BurntPineapples/kaboombox/hardware/enclosure/controller_full.step

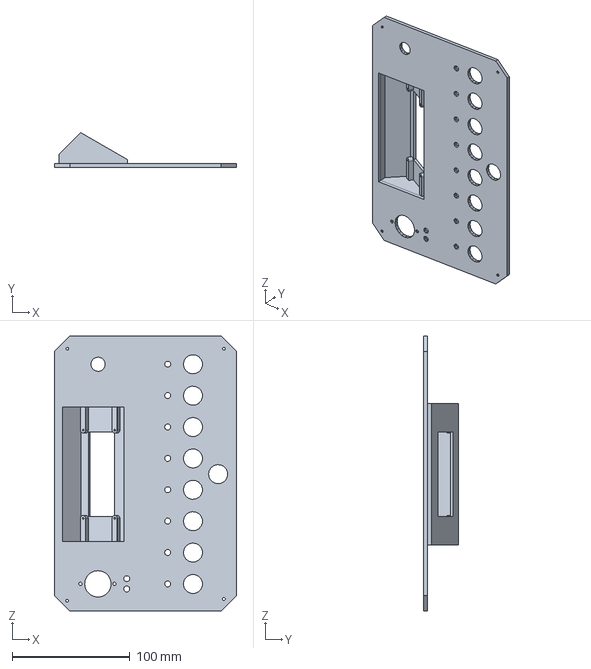
[picture p12: CAD file, 2026-11-06]
hardware/enclosure/controller_full.step
154.9 x 29.7 x 233.7 mm
