BurntPineapples/kaboombox/hardware/enclosure/field_floor_test.stl

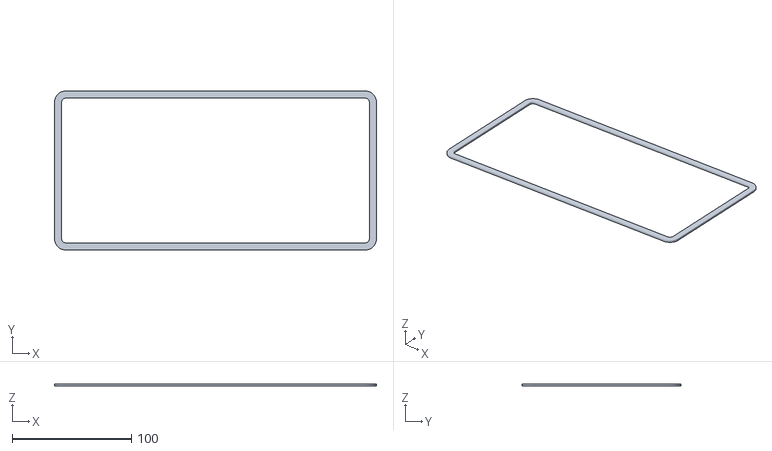
[picture p13: CAD file, 2026-11-06]
hardware/enclosure/field_floor_test.stl
269.9 x 133.4 x 2.00
