BurntPineapples/kaboombox/hardware/enclosure/plate-source/Controller_9.200x6.100.stl

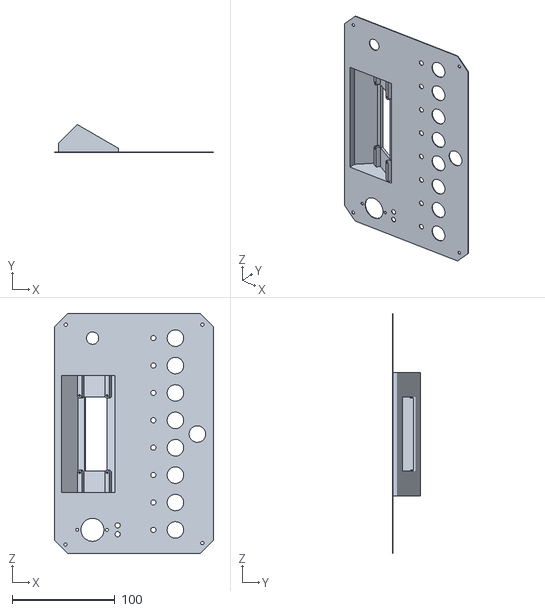
[picture p14: CAD file, 2026-11-06]
hardware/enclosure/plate-source/Controller_9.200x6.100.stl
154.9 x 27.1 x 233.7
