BurntPineapples/kaboombox/hardware/enclosure/field_prop.step

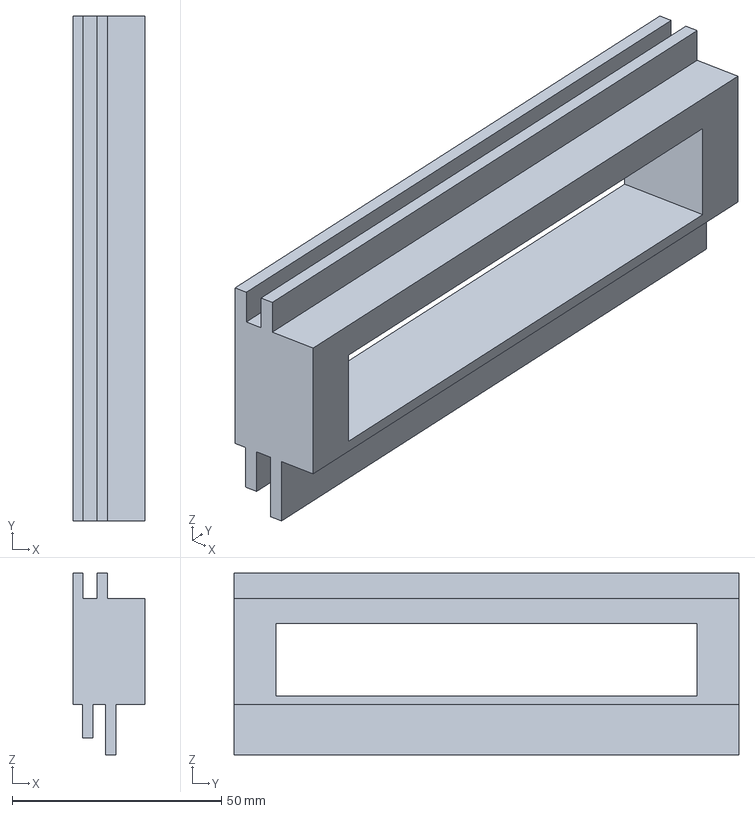
[picture p15: CAD file, 2026-11-06]
hardware/enclosure/field_prop.step
17.3 x 120.7 x 43.4 mm
