BurntPineapples/kaboombox/hardware/enclosure/plate-source/Controller.stl

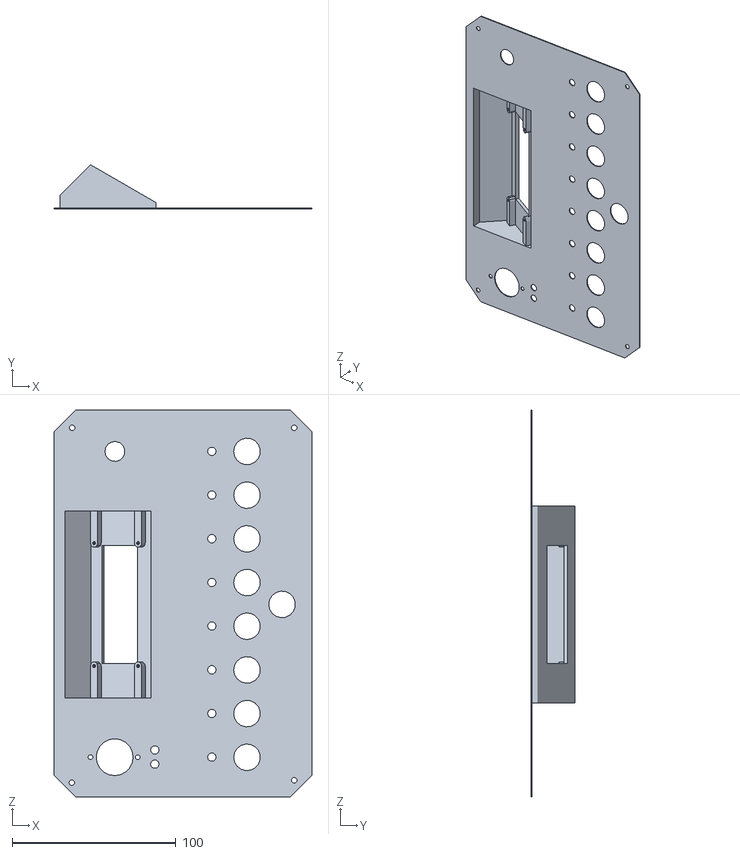
[picture p16: CAD file, 2026-11-06]
hardware/enclosure/plate-source/Controller.stl
157.5 x 27.1 x 236.2
