BurntPineapples/kaboombox/hardware/enclosure/controller_plate_test.stl

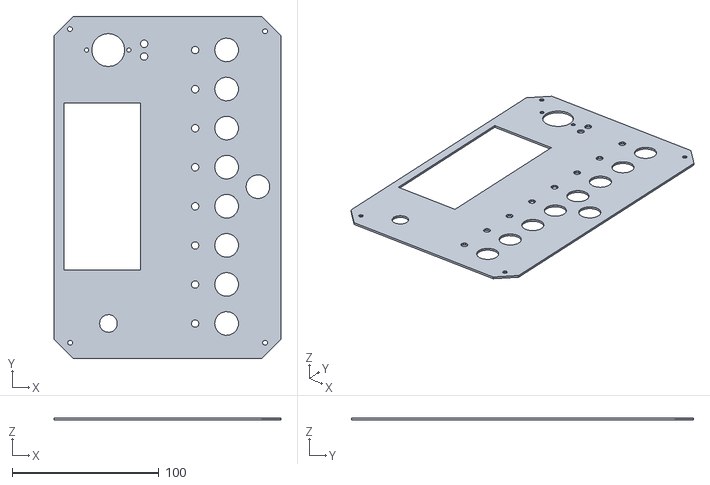
[picture p17: CAD file, 2026-11-06]
hardware/enclosure/controller_plate_test.stl
154.9 x 233.7 x 1.50
