BurntPineapples/kaboombox/hardware/enclosure/legs_placed.step

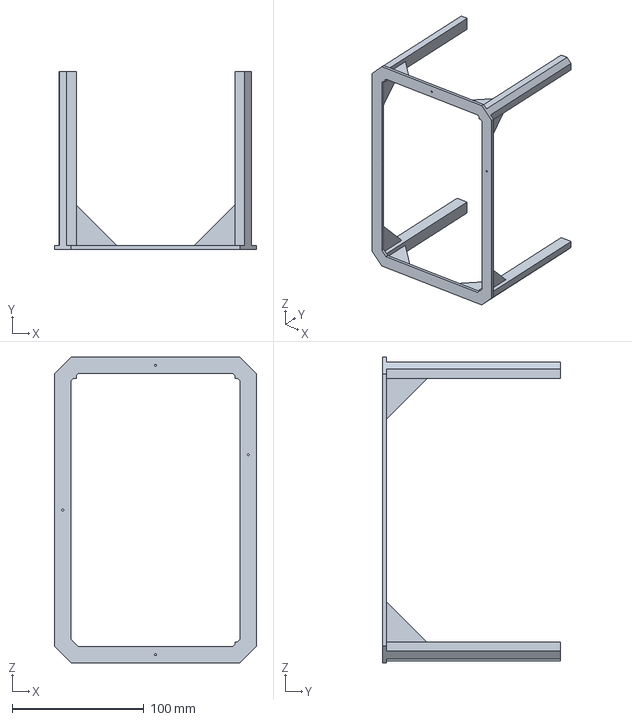
[picture p18: CAD file, 2026-11-06]
hardware/enclosure/legs_placed.step
153.4 x 134.9 x 232.2 mm
