BurntPineapples/kaboombox/hardware/enclosure/field_floor.step

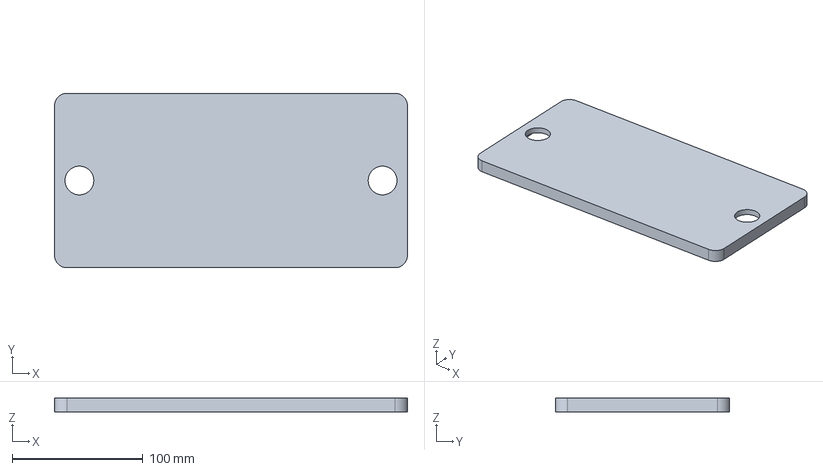
[picture p19: CAD file, 2026-11-06]
hardware/enclosure/field_floor.step
269.9 x 133.3 x 11.0 mm
