BurntPineapples/kaboombox/hardware/enclosure/legs_test.stl

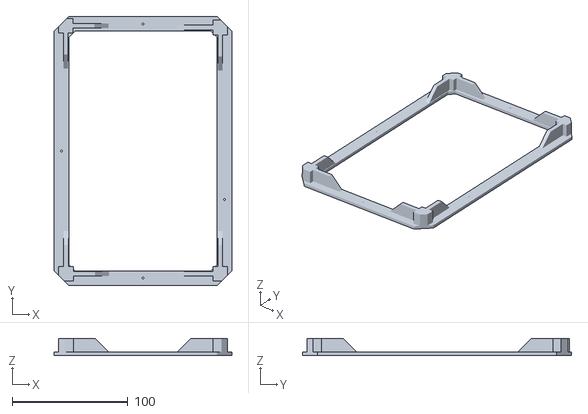
[picture p20: CAD file, 2026-11-06]
hardware/enclosure/legs_test.stl
153.4 x 232.2 x 15.0
