BurntPineapples/kaboombox/hardware/enclosure/tray_print.stl

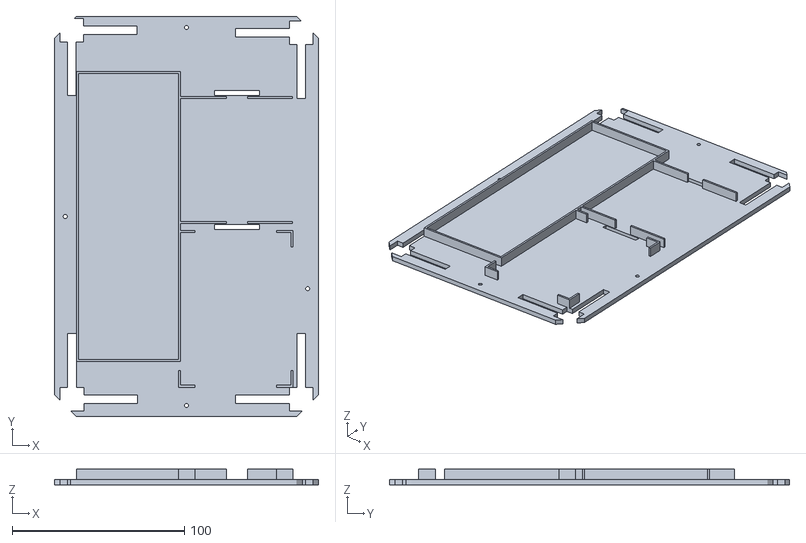
[picture p21: CAD file, 2026-11-06]
hardware/enclosure/tray_print.stl
153.4 x 232.2 x 9.00
