BurntPineapples/kaboombox/hardware/enclosure/field_prop_test.stl

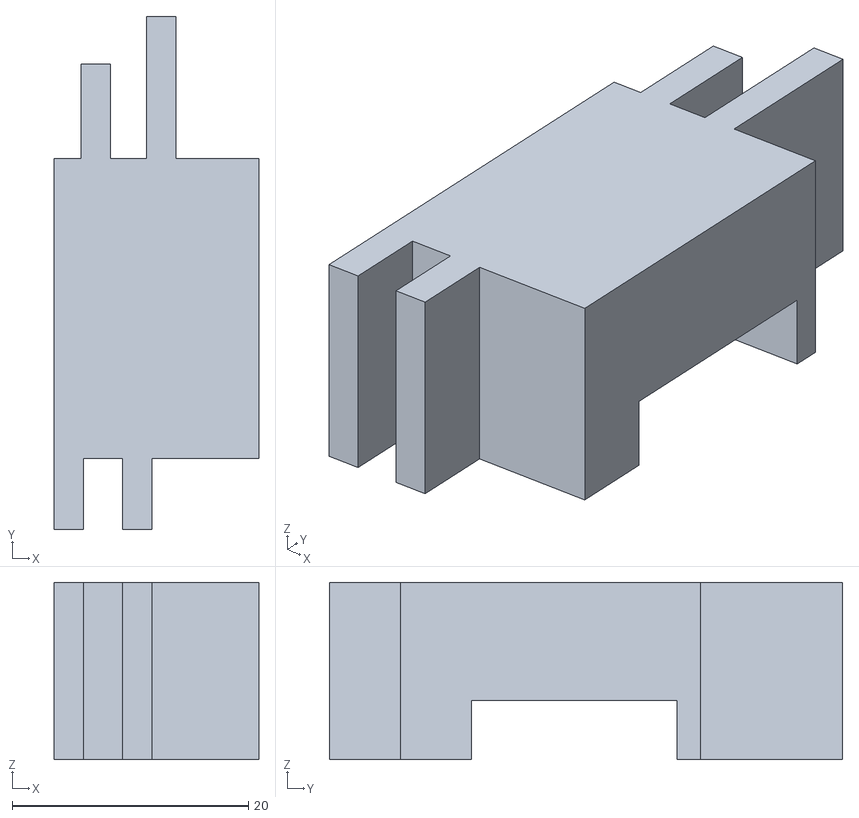
[picture p22: CAD file, 2026-11-06]
hardware/enclosure/field_prop_test.stl
17.3 x 43.4 x 15.0
