BurntPineapples/kaboombox/(list of files, cad)

Other CAD files:
hardware/enclosure/tray_placed.step
hardware/enclosure/legs_print.stl
hardware/enclosure/controller_full.stl
hardware/enclosure/field_floor.stl
hardware/enclosure/field_prop.stl
