BurntPineapples/kaboombox/docs/FIELD_WIRING_GUIDE.html

# Field box: power & alligator-clip wiring

The one that trips people up: the negative uses a Wago, the positive (12V) does not; it hops across the relay COM screws instead.

The big idea: the 12 V goes OUT through the relays to the firework and comes BACK through one shared Wago. So you have one Wago (the negative) collecting all the returns, and the positive spread across the 8 relay COM screws by little jumpers. Each firework sits in the middle, held by two alligator clips.

## The whole loop, one channel

Follow the red line: battery + → fuse → relay COM → NO → clip A → steel wool. Then the black line: steel wool → clip B → NEG Wago → battery −. When the relay clicks, that loop completes and the strand burns.

## 1. The NEGATIVE Wago: what goes in (you already did this)

One shared junction. A 5-slot Wago holds 5 wires; chain a second one for the rest.

Into the NEG Wago | How many
Battery − lead | 1
Clip B return from each channel (steel-wool far end) | 8
ESP32 GND wire | 1
= 10 wires total → two 5-slot Wagos bridged with one short jumper

## 2. The POSITIVE: no Wago, it hops across the COM screws

The 12V positive is not collected in a Wago. It's fed to relay COM1 and then daisy-chained screw-to-screw across all 8 COMs.

Step | Wire
1 | Battery + → fuse → relay COM1 screw
2 | Short 20AWG jumper: COM1 → COM2
3 | Repeat: COM2→COM3, COM3→COM4 … COM7→COM8 (7 jumpers total)
4 | Middle COM screws hold two wires (jumper in + jumper out). Twist the two stripped ends together before clamping so both stay put

Would a Wago work for the positive too? Yes. Instead of the daisy chain you can run battery+ → fuse → a second Wago, then one wire from that Wago to each COM. Same result, just more wire. The daisy chain uses fewer parts, so most people do that.

## 3. Where the alligator clips go

Two clips per firework, one on each end of the steel-wool strand.

Clip | Wired from | To
Clip A (hot) | relay NO of that channel | one end of the steel wool
Clip B (return) | the NEG Wago | the other end of the steel wool

So each channel needs a lead from its NO ending in clip A, and a lead from the NEG Wago ending in clip B. The strand bridges the two clips; that's what the relay switches on and the sense circuit reads.

## Quick reference: the 3 positives on this box

Positive | Volts | Feeds | Wago?
Firing 12V | 12 | relay COM daisy chain → NO → fireworks | No, daisy chain
Relay VCC | 5 | relay module coils (one wire from ESP32 VIN) | No, single wire
Sense 3V3 | 3.3 | 100k pull-ups on channels 1–4 | No

Fuse safety: the fuse is the master kill. Leave it out of the holder while wiring and clipping strands. With no fuse, the whole 12V positive chain is dead. Insert it only when everyone is clear and you're ready to fire, then pull it right back out.

Wire size: the ELEGOO relay screw terminals take about 16-18 AWG at most. 14 AWG doesn't fit. Use a short 16/18 AWG pigtail or a ferrule into the terminal.

## 4. Optional: a 120V wall-power channel

One channel can switch a wall outlet instead of an igniter: inflatables, lights, a fog machine, anything that plugs into the wall. In the panel menu set that channel to ON/OFF (or HOLD) under Channel setup. ARMED ALL never turns it on, DISARMED turns it off, and the Link-lost hold setting decides how long it stays on if the radio drops. It will show "no continuity"; that's expected.

Wall power can kill you. A mistake here can put 120V on the igniter clips or the ESP32. Only do this if you're comfortable wiring mains, and do every step in the checklist below. US 120V only: 230V countries need different plugs, wire colours and fuse values.

How it works: the relay switches only the hot wire of an ordinary cord. Neutral and ground go straight through on Wagos and never touch the relay board. This example uses channel 8.

From | Through | To
Wall plug HOT (narrow blade, usually black) | Inline fuse holder, 250V, 5A slow-blow | Relay COM8
Relay NO8 | | Female plug HOT (brass screw)
Wall plug NEUTRAL (wide blade, usually white) | Wago | Female plug NEUTRAL (silver screw)
Wall plug GROUND (green) | Wago | Female plug GROUND (green screw)
Channel 8 continuity-sense wire | | Nothing. Leave that sense terminal empty

Before you cut anything, check with a continuity meter which wire goes to the narrow blade. Don't trust the colours alone.

### Must-do checklist

1. Remove CH8's COM jumper. All the other COMs are tied to the 12V firing bus. If CH8's COM stays jumpered, 120V lands on every channel's igniter clips.
2. Disconnect CH8's sense wire (on a breadboard, take out its 10k series resistor). Through that resistor 120V would reach the ESP32 pin, kill the board and make the whole low-voltage side live. The 10k only protects against 12V.
3. Unplugging the 12V battery doesn't make shared wiring safe. Steps 1 and 2 are needed even if 12V and 120V are never connected at the same time.
4. Switch the hot only, never the neutral.
5. The fuse must be rated 250V. Don't reuse the 12V system's automotive blade fuse: blade fuses are rated 32V and can keep arcing on wall power instead of breaking the circuit.
6. Fuse size: start at 5A. If a fast-blow pops when a blower motor starts, step up to 6.3A, then 7A. Never above 8A on 18 AWG cord. A fuse that blows while the device is already running means a real fault: unplug it and find the problem.
7. Load limit about 5A / 600W. Fine for inflatables, lights and fog machines. No heaters or big motors.
8. Strain relief: two zip ties pulled tight around each cord just inside the box. Smooth the entry hole, or wrap the cord in tape where it passes through. Tug on the cord: the screw terminals must not feel the pull.
9. Keep mains wires on one side of the box, zip-tied, away from the ESP32 and the 12V wiring. The ELEGOO board has bare solder joints on the back, so mount it on standoffs with tape or plastic under the mains channels. If any part of the box is metal, bond it to the green ground wire.
10. Label the channel "120V" on the box so nobody clips an igniter to it.
11. Use a GFCI outlet (the kind with TEST/RESET buttons) or a plug-in GFCI adapter, especially with people around.
12. Always unplug the wall cord before you open the box. Keep the lid shut while it's in use.
13. First power-up check, with the wall cord still unplugged, using a meter: wall plug HOT to female plug HOT reads open; turn channel 8 on from the panel and it beeps; wall plug HOT to the 12V bus, and to GND, reads open with the relay off and on.

Parts (see the README parts list for search terms): a Leviton 515CV female cord-end plug, a 5x20 mm inline fuse holder kit with 250V glass fuses, an old 3-wire PC power cord (or a 16/3 extension cord cut in half, which gives both ends), two Wagos, and ideally a plug-in GFCI adapter. Twist the fuse holder's strands or crimp a ferrule before they go into the relay terminal; don't tin them with solder.

Leave the 12V side alone. Don't bypass the 10A firing fuse, the shared ground, the 10k series resistors or the arming key to make room for this channel.
