BurntPineapples/kaboombox/hardware/pcb/field/field-paper-check-1to1.pdf

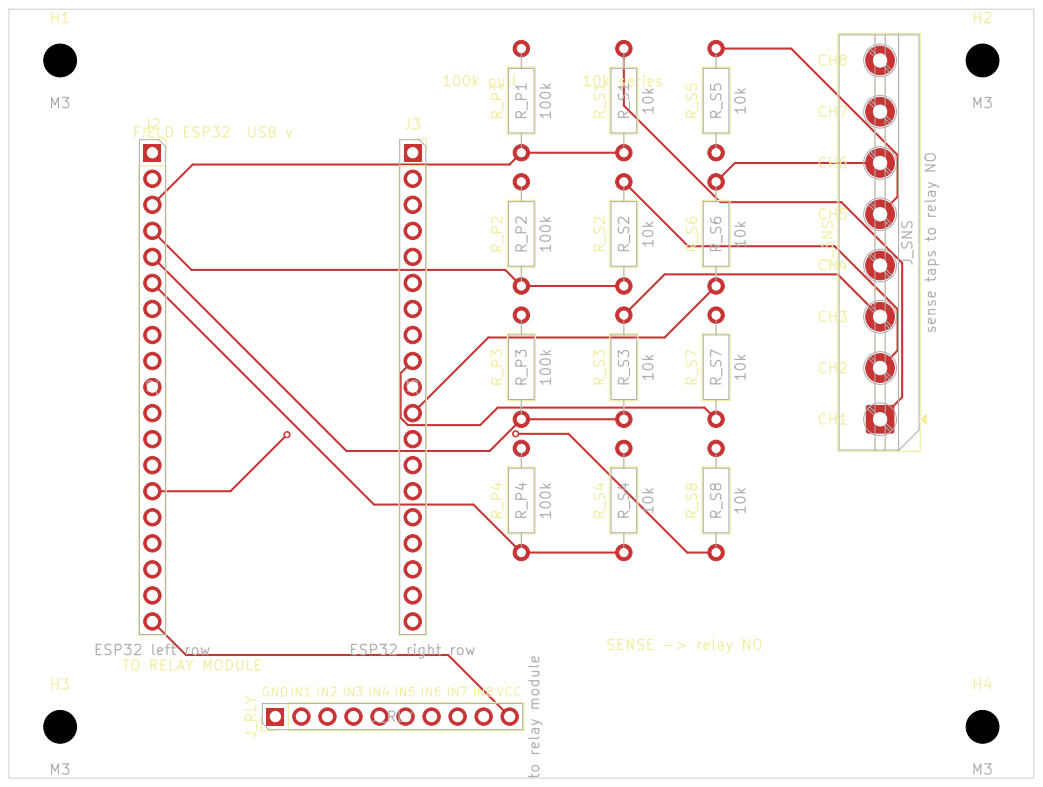
[picture p23: page 1]
