BurntPineapples/kaboombox/hardware/pcb/field/field.kicad_pcb

## KiCad design hardware/pcb/field/field.kicad_pcb (2026-11-06)

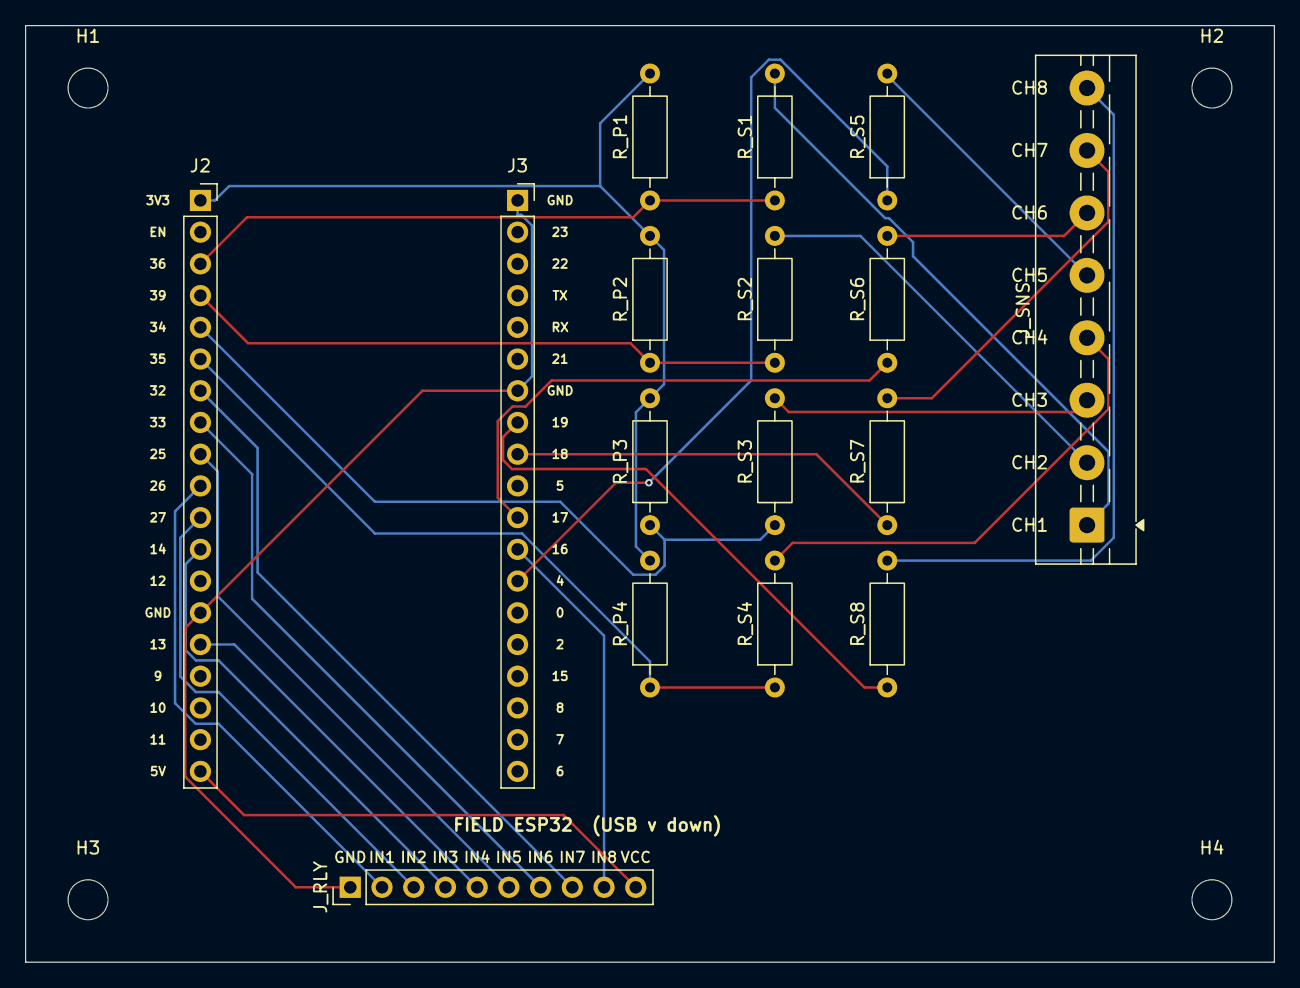
[picture p24: board field.kicad_pcb from above]

Board: 2 copper layers, 100.0 x 75.0 mm, 20 parts (0 on the bottom side), 27 nets.

Parts:
H1, H2, H3, H4: M3; MountingHole_3.2mm_M3
J2: ESP32 left; PinSocket_1x19_P2.54mm_Vertical
J3: ESP32 right; PinSocket_1x19_P2.54mm_Vertical
J_RLY: to relay module; PinHeader_1x10_P2.54mm_Vertical
J_SNS: sense taps to relay NO; TerminalBlock_MaiXu_MX126-5.0-08P_1x08_P5.00mm
R_P1, R_P2, R_P3, R_P4: 100k; R_Axial_DIN0207_L6.3mm_D2.5mm_P10.16mm_Horizontal
R_S1, R_S2, R_S3, R_S4, R_S5, R_S6, R_S7, R_S8: 10k; R_Axial_DIN0207_L6.3mm_D2.5mm_P10.16mm_Horizontal

Connections:
3V3: J2.1, R_P1.2, R_P2.2, R_P3.2, R_P4.2
5V: J2.19, J_RLY.10
GND: J2.14, J3.1, J3.7, J_RLY.1
IN1: J2.10, J_RLY.2
IN2: J2.11, J_RLY.3
IN3: J2.12, J_RLY.4
IN4: J2.15, J_RLY.5
IN5: J2.9, J_RLY.6
IN6: J2.8, J_RLY.7
IN7: J2.7, J_RLY.8
IN8: J3.12, J_RLY.9
NO1: J_SNS.1, R_S1.2
NO2: J_SNS.2, R_S2.2
NO3: J_SNS.3, R_S3.2
NO4: J_SNS.4, R_S4.2
NO5: J_SNS.5, R_S5.2
NO6: J_SNS.6, R_S6.2
NO7: J_SNS.7, R_S7.2
NO8: J_SNS.8, R_S8.2
SENSE1: J2.3, R_P1.1, R_S1.1
SENSE2: J2.4, R_P2.1, R_S2.1
SENSE3: J2.5, R_P3.1, R_S3.1
SENSE4: J2.6, R_P4.1, R_S4.1
SENSE5: J3.13, R_S5.1
SENSE6: J3.11, R_S6.1
SENSE7: J3.9, R_S7.1
SENSE8: J3.8, R_S8.1
