BurntPineapples/kaboombox/hardware/pcb/controller/controller.kicad_pcb

## KiCad design hardware/pcb/controller/controller.kicad_pcb (2026-11-06)

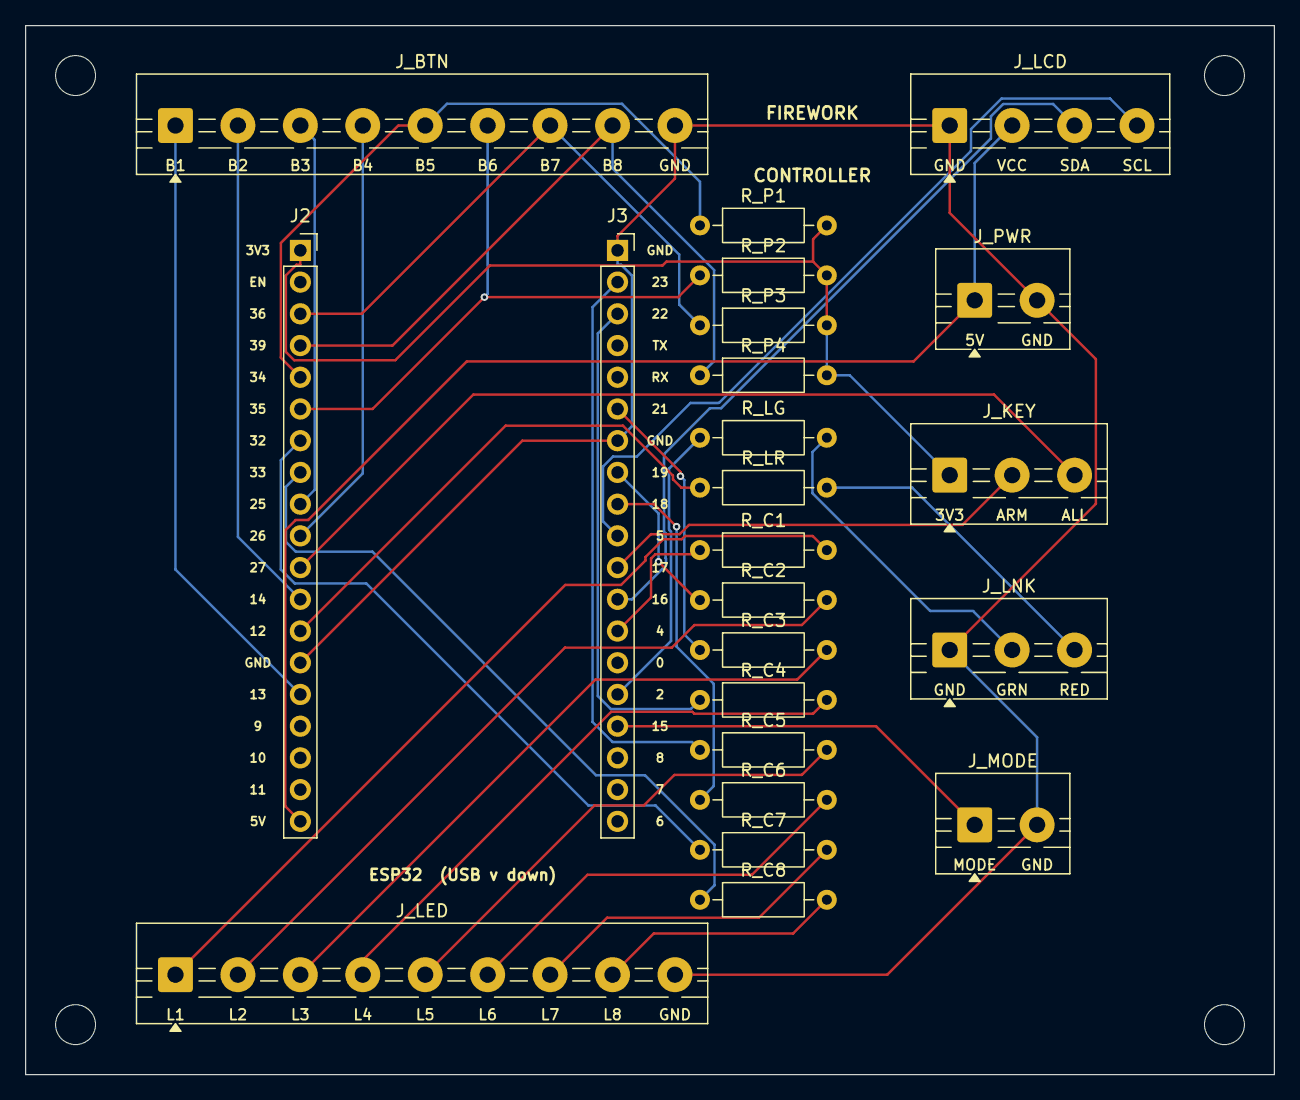
[picture p25: board controller.kicad_pcb from above]

Board: 2 copper layers, 100.0 x 84.0 mm, 27 parts (0 on the bottom side), 36 nets.

Parts:
H1, H2, H3, H4: M3; MountingHole_3.2mm_M3
J2: ESP32 left; PinSocket_1x19_P2.54mm_Vertical
J3: ESP32 right; PinSocket_1x19_P2.54mm_Vertical
J_BTN: fire buttons 1-8 +GND; TerminalBlock_MaiXu_MX126-5.0-09P_1x09_P5.00mm
J_KEY: key switch; TerminalBlock_MaiXu_MX126-5.0-03P_1x03_P5.00mm
J_LCD: 16x2 I2C LCD; TerminalBlock_MaiXu_MX126-5.0-04P_1x04_P5.00mm
J_LED: channel LEDs 1-8 +GND; TerminalBlock_MaiXu_MX126-5.0-09P_1x09_P5.00mm
J_LNK: link LEDs G/R +GND; TerminalBlock_MaiXu_MX126-5.0-03P_1x03_P5.00mm
J_MODE: mode button; TerminalBlock_MaiXu_MX126-5.0-02P_1x02_P5.00mm
J_PWR: 5V power in; TerminalBlock_MaiXu_MX126-5.0-02P_1x02_P5.00mm
R_C1, R_C2, R_C3, R_C4, R_C5, R_C6, R_C7, R_C8: 220; R_Axial_DIN0207_L6.3mm_D2.5mm_P10.16mm_Horizontal
R_LG: 220; R_Axial_DIN0207_L6.3mm_D2.5mm_P10.16mm_Horizontal
R_LR: 220; R_Axial_DIN0207_L6.3mm_D2.5mm_P10.16mm_Horizontal
R_P1, R_P2, R_P3, R_P4: 10k; R_Axial_DIN0207_L6.3mm_D2.5mm_P10.16mm_Horizontal

Connections:
3V3: J2.1, J_KEY.1, R_P1.2, R_P2.2, R_P3.2, R_P4.2
5V: J2.19, J_LCD.2, J_PWR.1
BTN1: J2.15, J_BTN.1
BTN2: J2.12, J_BTN.2
BTN3: J2.9, J_BTN.3
BTN4: J2.10, J_BTN.4
BTN5: J2.5, J_BTN.5, R_P1.1
BTN6: J2.6, J_BTN.6, R_P2.1
BTN7: J2.3, J_BTN.7, R_P3.1
BTN8: J2.4, J_BTN.8, R_P4.1
GND: J2.14, J3.1, J3.7, J_BTN.9, J_LCD.1, J_LED.9, J_LNK.1, J_MODE.2, J_PWR.2
KEY_ALL: J2.11, J_KEY.3
KEY_ARM: J3.11, J_KEY.2
LCD_SCL: J3.10, J_LCD.4
LCD_SDA: J3.12, J_LCD.3
LED1: J3.13, R_C1.1
LED1_A: J_LED.1, R_C1.2
LED2: J3.8, R_C2.1
LED2_A: J_LED.2, R_C2.2
LED3: J3.6, R_C3.1
LED3_A: J_LED.3, R_C3.2
LED4: J3.3, R_C4.1
LED4_A: J_LED.4, R_C4.2
LED5: J3.2, R_C5.1
LED5_A: J_LED.5, R_C5.2
LED6: J3.9, R_C6.1
LED6_A: J_LED.6, R_C6.2
LED7: J2.7, R_C7.1
LED7_A: J_LED.7, R_C7.2
LED8: J2.8, R_C8.1
LED8_A: J_LED.8, R_C8.2
LED_FAIL: J2.13, R_LR.1
LED_PASS: J3.15, R_LG.1
LNKG_A: J_LNK.2, R_LG.2
LNKR_A: J_LNK.3, R_LR.2
MODE_BTN: J3.16, J_MODE.1
