BurntPineapples/kaboombox/firmware/firework_field/firework_field.ino

// Copyright (c) 2026 Burnt pineapples
// SPDX-License-Identifier: MIT
// Provided as-is with no warranty. Read DISCLAIMER.md before building or using this.

/*
 * KaBoomBox field sketch.
 * Flash this to the relay box: the ESP32 wired to the 8-channel relay module.
 *
 *  Board setting in Arduino IDE: "ESP32 Dev Module"
 *  No extra libraries needed.
 *
 *  Before your first flash, put your panel board's MAC in CONTROLLER_MAC
 *  below, and make a secrets.h with your signing key (see secrets.example.h).
 *  The limits you might want to change (pulse length cap, heartbeat
 *  timeout) are in the #defines under the Msg struct.
 *
 *  v3: flash the CONTROLLER with its v3 sketch too, with the SAME secrets.h.
 *  Boxes on different versions, or with different keys, ignore each other
 *  (no link, nothing fires) - they never misfire.
 *
 *  FIRST-TIME PAIRING:
 *   0. Copy secrets.example.h to secrets.h in BOTH sketch folders and put
 *      the same random key in both (instructions are in the file).
 *   1. Flash both sketches. Open Serial Monitor at 115200 baud.
 *   2. Each board prints its own MAC address at boot.
 *   3. Paste the CONTROLLER's MAC into CONTROLLER_MAC below, re-flash.
 *   4. Paste THIS board's MAC into FIELD_MAC in the controller sketch.
 *
 *  WHAT THE CONTROLLER SENDS:
 *   - FIRE: pulse a relay for that channel's pulse length (set in the
 *     controller menu, capped here at MAX_PULSE_MS).
 *   - HEARTBEAT (every 300 ms): key mode + which ON/OFF and HOLD
 *     channels should be on right now. Relays follow it.
 *
 *  SAFETY DESIGN:
 *   - Packets from any other MAC, or other firmware version, are ignored.
 *   - Every packet must be signed with your key from secrets.h and be new
 *     (session number + counter), so a fake or recorded-and-replayed packet
 *     can't arm or fire this box.
 *   - Firing requires a fresh heartbeat (<1.5s) saying ARMED / ARMED ALL.
 *   - Key to DISARMED -> every relay opens.
 *   - Link lost -> pulses cut at once, HOLD channels off at once, fire
 *     requests refused. ON/OFF channels stay on for the controller's
 *     "Link-lost hold" setting (default: off at once), then open.
 *     When the link returns, relays follow the controller again.
 *   - Relay outputs are driven OFF as the very first thing in setup().
 *   - The real safety is physical: no fuse in the 12V holder = the
 *     firing circuit is dead no matter what this code does.
 *
 *  CONTINUITY SENSE (per channel):
 *   pullup --+-- sense pin
 *            +-- [10k series] -- relay NO terminal (igniter + line)
 *   Channels 1-4 (pins 36/39/34/35): external 100k pullup to 3V3 required.
 *   Channels 5-8 (pins 4/17/18/19): internal pullup, no resistor needed.
 *   Igniter present pulls the pin LOW. The 10k series resistor protects
 *   the pin from the 12V that appears on the line while the relay fires.
 */

#include <WiFi.h>
#include <esp_now.h>
#include <esp_wifi.h>
#include <stddef.h>
#include "mbedtls/md.h"
#include "secrets.h"   // your private signing key. If this line errors: copy secrets.example.h to secrets.h
#if KABOOM_KEY_IS_PLACEHOLDER
#error "secrets.h still has the placeholder key. Put your own random key in it (see secrets.example.h)."
#endif

#define USE_LONG_RANGE 0   // 1 = ESP32 long-range radio (more range, lower speed). Set the SAME in the controller sketch.

// The panel box's MAC address. The panel prints its own MAC on the Serial
// Monitor (115200 baud) at boot: EC:E3:34:19:B1:F0 -> {0xEC, 0xE3, ...}
uint8_t CONTROLLER_MAC[6] = {0xEC, 0xE3, 0x34, 0x19, 0xB1, 0xF0};

// Pin map (matches the wiring diagram). List order is channel order:
// RELAY_PIN[0] and SENSE_PIN[0] are channel 1. If you rewire, change the numbers here.
// Sense pins 34-39 are input-only with no internal pull-up, which is why channels
// 1-4 need the external 100k pull-ups. Don't put a relay on 34-39, they can't drive outputs.
const int RELAY_PIN[8] = {26, 27, 14, 13, 25, 33, 32, 16}; // ELEGOO IN1-IN8, active LOW
const int SENSE_PIN[8] = {36, 39, 34, 35, 4, 17, 18, 19};  // LOW = igniter connected

// Radio protocol. Must match the panel sketch exactly, down to the Msg struct.
// If you change any of it, change PROTO_VER in BOTH sketches.
#define PROTO_VER    0xA3   // first byte of every packet; not 1-5 so a v1 box can't mistake it for a message type.
                            // 0xA3 = v3, signed messages. v2 (0xA2) boxes ignore v3 ones and vice versa.
#define NO_HEARTBEAT 0xFF   // STATUS.mode when we aren't hearing the controller
#define HOLD_FOREVER 0xFFFF
enum Mode : uint8_t { MODE_DISARMED = 0, MODE_ARMED = 1, MODE_ARMED_ALL = 2 };
#define MSG_HEARTBEAT 1
#define MSG_FIRE      2
#define MSG_PING      3
#define MSG_PONG      4
#define MSG_STATUS    5

typedef struct __attribute__((packed)) {
  uint8_t  ver;
  uint8_t  type;
  uint8_t  mode;       // controller: key mode | field STATUS: mode it hears, NO_HEARTBEAT if none
  uint8_t  mask;       // FIRE: channels to pulse | HEARTBEAT: ON/OFF channels on | STATUS: continuity
  uint8_t  mask2;      // HEARTBEAT: HOLD channels on | STATUS: fired channels
  uint8_t  mask3;      // STATUS: relays closed right now
  uint16_t holdS;      // HEARTBEAT: link-lost hold for ON/OFF channels (HOLD_FOREVER = until link back)
  uint32_t uptimeS;    // STATUS: field uptime
  uint16_t pulseMs[8]; // FIRE: pulse length per channel
  uint32_t fieldNonce; // random number the field picks for each session; the panel echoes it back
  uint32_t ctrlNonce;  // random number the panel picks at boot
  uint32_t counter;    // goes up by one with every message the sender sends
  uint8_t  tag[16];    // signature: HMAC-SHA256 of everything above with KABOOM_KEY, first 16 bytes
} Msg;

// Message signing (the same two functions are in the panel sketch).
// Only a box that has your KABOOM_KEY can make a tag that checks out, so a fake
// panel can't arm or fire this box, and a changed packet fails the check.
void makeTag(const Msg &m, uint8_t out[16]) {
  uint8_t full[32];
  mbedtls_md_hmac(mbedtls_md_info_from_type(MBEDTLS_MD_SHA256), KABOOM_KEY, sizeof(KABOOM_KEY),
                  (const uint8_t *)&m, offsetof(Msg, tag), full);
  memcpy(out, full, 16);
}

bool tagOk(const Msg &m) {
  uint8_t t[16], diff = 0;
  makeTag(m, t);
  for (int i = 0; i < 16; i++) diff |= t[i] ^ m.tag[i];   // compare every byte, no early exit
  return diff == 0;
}

uint32_t newNonce() {   // hardware random number, never 0 (0 means "not known yet")
  uint32_t n;
  do { n = esp_random(); } while (n == 0);
  return n;
}

// Limits, in milliseconds. These are enforced here on the field box, whatever the panel asks for.
#define MAX_PULSE_MS      10000 // hard cap on any one pulse, whatever the controller asks
#define MIN_PULSE_MS      50    // shorter requests are stretched to this
#define HEARTBEAT_TIMEOUT 1500  // no heartbeat for this long = disarm and cut any pulse. This is a
                                // safety limit: never make it longer. Shorter is OK as long as it
                                // stays several times the panel's HEARTBEAT_MS (300).
#define STATUS_MS         250   // controller measures link quality from these. If you change it,
                                // change STATUS_PER_2S in the panel sketch to 2000 / STATUS_MS.

// Runtime state
volatile uint8_t  ctrlMode = MODE_DISARMED;
volatile uint32_t lastHeartbeatMs = 0;
volatile uint8_t  fireRequestMask = 0;
volatile uint16_t fireReqMs[8];
volatile uint8_t  toggleMask = 0;    // ON/OFF channels the controller wants on
volatile uint8_t  holdMask = 0;      // HOLD channels the controller wants on
volatile uint16_t linkHoldS = 0;
volatile bool     pongRequested = false;

// Replay protection. A recorded packet is useless later: it carries an old
// session number (fieldNonce) or a counter we've already seen.
volatile uint32_t sessionNonce = 0;     // set in setup(), changed whenever the panel reboots
volatile uint32_t knownCtrlNonce = 0;   // the panel boot we're talking to
volatile uint32_t lastCtrlCounter = 0;  // highest counter accepted from that boot
uint32_t txCounter = 0;

uint8_t  firedMask = 0;
uint8_t  lastContinuity = 0xFF; // impossible value forces first print
uint8_t  lastRelays = 0;
uint32_t pulseStart[8] = {0};
uint16_t pulseLen[8] = {0};     // 0 = no pulse running
uint32_t lastStatusSent = 0;
bool     linkWasUp = false;

void reply(uint8_t type, uint8_t mode, uint8_t cont, uint8_t relays) {
  Msg m = {};
  m.ver = PROTO_VER;
  m.type = type;
  m.mode = mode;
  m.mask = cont;
  m.mask2 = firedMask;
  m.mask3 = relays;
  m.uptimeS = millis() / 1000;
  m.fieldNonce = sessionNonce;
  m.counter = ++txCounter;
  makeTag(m, m.tag);
  esp_now_send(CONTROLLER_MAC, (uint8_t *)&m, sizeof(m));
}

void handleRecv(const uint8_t *mac, const uint8_t *data, int len) {
  if (memcmp(mac, CONTROLLER_MAC, 6) != 0) return;            // strangers ignored
  if (len != (int)sizeof(Msg) || data[0] != PROTO_VER) return; // other firmware ignored
  Msg m;
  memcpy(&m, data, sizeof(m));

  // Nothing below runs unless the packet is signed with our key and is new.
  if (!tagOk(m)) return;                        // wrong key, or not from our panel
  if (m.fieldNonce != sessionNonce) return;     // made for an earlier session: stale or replayed
  if (m.ctrlNonce != knownCtrlNonce) {          // the panel has (re)booted: start a fresh session.
    knownCtrlNonce = m.ctrlNonce;               // Changing sessionNonce makes anything recorded
    lastCtrlCounter = m.counter;                // before now useless. This packet is not acted on;
    sessionNonce = newNonce();                  // the panel picks up the new number from our next
    return;                                     // STATUS, about 250 ms later.
  }
  if (m.counter <= lastCtrlCounter) return;     // already seen: a replay
  lastCtrlCounter = m.counter;

  // every controller message doubles as a heartbeat
  ctrlMode = m.mode;
  lastHeartbeatMs = millis();

  if (m.type == MSG_HEARTBEAT) {
    toggleMask = m.mask;
    holdMask = m.mask2;
    linkHoldS = m.holdS;
  } else if (m.type == MSG_PING) {
    pongRequested = true;             // answered from loop()
  } else if (m.type == MSG_FIRE) {
    for (int i = 0; i < 8; i++) if (bitRead(m.mask, i)) fireReqMs[i] = m.pulseMs[i];
    fireRequestMask |= m.mask;        // executed from loop()
  }
}

#if defined(ESP_ARDUINO_VERSION_MAJOR) && ESP_ARDUINO_VERSION_MAJOR >= 3
void onRecv(const esp_now_recv_info_t *info, const uint8_t *data, int len) {
  handleRecv(info->src_addr, data, len);
}
#else
void onRecv(const uint8_t *mac, const uint8_t *data, int len) {
  handleRecv(mac, data, len);
}
#endif

uint8_t readContinuity() {
  uint8_t mask = 0;
  for (int i = 0; i < 8; i++) {
    if (digitalRead(SENSE_PIN[i]) == LOW) bitSet(mask, i);
  }
  return mask;
}

void setup() {
  // relays OFF before anything else can happen
  for (int i = 0; i < 8; i++) {
    pinMode(RELAY_PIN[i], OUTPUT);
    digitalWrite(RELAY_PIN[i], HIGH);
  }
  // sense channels 1-4 (pins 36/39/34/35): input-only pins, external 100k pullup required
  for (int i = 0; i < 4; i++) pinMode(SENSE_PIN[i], INPUT);
  // sense channels 5-8 (pins 4/17/18/19): use the chip's internal pullup, no resistor needed
  for (int i = 4; i < 8; i++) pinMode(SENSE_PIN[i], INPUT_PULLUP);

  Serial.begin(115200);

  WiFi.mode(WIFI_STA);
  WiFi.disconnect();
#if USE_LONG_RANGE
  esp_wifi_set_protocol(WIFI_IF_STA, WIFI_PROTOCOL_LR);
#endif
  sessionNonce = newNonce();   // after the radio is on, so the hardware random number generator has entropy
  Serial.println();
  Serial.println("=== FIELD UNIT v3 (relay box) ===");
  Serial.print("MY MAC - paste into FIELD_MAC in the controller sketch: ");
  Serial.println(WiFi.macAddress());

  if (esp_now_init() != ESP_OK) {
    Serial.println("ESP-NOW init FAILED - halting");
    while (true) delay(1000);
  }
  esp_now_register_recv_cb(onRecv);

  esp_now_peer_info_t peer = {};
  memcpy(peer.peer_addr, CONTROLLER_MAC, 6);
  peer.channel = 0;
  peer.encrypt = false;
  esp_now_add_peer(&peer);

  Serial.println("Ready. Relays inhibited until ARMED heartbeat arrives.");
}

void loop() {
  uint32_t now = millis();

  bool fresh = lastHeartbeatMs != 0 && (now - lastHeartbeatMs) < HEARTBEAT_TIMEOUT;
  bool keyOn = ctrlMode == MODE_ARMED || ctrlMode == MODE_ARMED_ALL;
  bool armed = fresh && keyOn;

  if (fresh != linkWasUp) {
    linkWasUp = fresh;
    if (fresh)                          Serial.println("LINK: controller heard");
    else if (linkHoldS == HOLD_FOREVER) Serial.println("LINK LOST - pulses cut, fire refused, ON/OFF held until link returns");
    else Serial.printf("LINK LOST - pulses cut, fire refused, ON/OFF held %us\n", (unsigned)linkHoldS);
  }

  // execute fire requests (only while armed with a fresh heartbeat)
  if (fireRequestMask) {
    uint8_t req = fireRequestMask;
    fireRequestMask = 0;
    if (armed) {
      for (int i = 0; i < 8; i++) {
        if (bitRead(req, i)) {
          pulseStart[i] = now;
          pulseLen[i] = constrain((int)fireReqMs[i], MIN_PULSE_MS, MAX_PULSE_MS);
          Serial.printf(">>> FIRING channel %d for %u ms\n", i + 1, pulseLen[i]);
        }
      }
    } else {
      Serial.println("Fire request REFUSED (disarmed or stale heartbeat)");
    }
  }

  // end pulses that have run their time
  for (int i = 0; i < 8; i++) {
    if (pulseLen[i] && now - pulseStart[i] >= pulseLen[i]) {
      pulseLen[i] = 0;
      bitSet(firedMask, i);
      Serial.printf("Channel %d pulse complete\n", i + 1);
    }
  }

  // hard safety: any disarm/link-loss kills pulses in progress
  if (!armed) {
    for (int i = 0; i < 8; i++) {
      if (pulseLen[i]) {
        Serial.printf("SAFETY: aborting pulse on channel %d\n", i + 1);
        pulseLen[i] = 0;
      }
    }
  }

  // ON/OFF + HOLD channels follow the heartbeat. On link loss, ON/OFF ones
  // ride through for the controller's hold setting; HOLD ones drop at once.
  uint8_t relays = 0;
  if (armed) relays = toggleMask | holdMask;
  else if (!fresh && keyOn && lastHeartbeatMs != 0 &&
           (linkHoldS == HOLD_FOREVER || now - lastHeartbeatMs < HEARTBEAT_TIMEOUT + linkHoldS * 1000UL))
    relays = toggleMask;
  for (int i = 0; i < 8; i++) {
    if (pulseLen[i]) bitSet(relays, i);
    digitalWrite(RELAY_PIN[i], bitRead(relays, i) ? LOW : HIGH); // active LOW
  }
  if (relays != lastRelays) {
    lastRelays = relays;
    Serial.print("Relays [ch 8..1]: ");
    for (int i = 7; i >= 0; i--) Serial.print(bitRead(relays, i));
    Serial.println();
  }

  // key turned to DISARMED clears the fired list: any channel still
  // showing continuity becomes launchable again after re-arming
  if (fresh && ctrlMode == MODE_DISARMED && firedMask != 0) {
    firedMask = 0;
    Serial.println("DISARMED: fired list cleared - channels with continuity are ready again");
  }

  uint8_t heard = fresh ? ctrlMode : NO_HEARTBEAT;

  // answer link-test pings
  if (pongRequested) {
    pongRequested = false;
    reply(MSG_PONG, heard, lastContinuity, relays);
  }

  // status broadcast: continuity + fired + relays
  if (now - lastStatusSent >= STATUS_MS) {
    lastStatusSent = now;
    uint8_t cont = readContinuity();
    if (cont != lastContinuity) {
      lastContinuity = cont;
      Serial.print("Continuity [ch 8..1]: ");
      for (int i = 7; i >= 0; i--) Serial.print(bitRead(cont, i));
      Serial.println();
    }
    reply(MSG_STATUS, heard, cont, relays);
  }

  delay(5);
}
