BurntPineapples/kaboombox/(commit log)

2026-11-06 Import project as-is (original folder layout)
    [controller.kicad_pcb, controller_full.step, controller_full.stl, controller_plate_test.stl, field.kicad_pcb, field_floor.step, field_floor.stl, field_floor_test.stl]
2026-11-06 Reorganize into firmware/, hardware/, docs/; archive superseded designs
    - firmware/: controller + field sketches
    - hardware/pcb/: current controller and field boards + generator scripts
    - hardware/pcb/archive/: superseded tray/lid boards and their scripts
    - hardware/enclosure/: build123d scripts and current STEP/STL outputs
    - hardware/enclosure/archive/: old OpenSCAD iterations
    - hardware/enclosure/inventor/: copies of the Inventor parts and source STLs
    - docs/archive/: docs that still show the removed 7-segment display
    [Controller.stl, Controller_9.200x6.100.stl, controller.kicad_pcb, controller_full.step, controller_full.stl, controller_plate_test.stl, field.kicad_pcb, field_floor.step]
2026-11-06 Add photos, wiring diagrams, full parts list and STL guide
2026-11-06 Rename to KaBoomBox, add work-in-progress warning, dark wiring diagrams as images
2026-11-06 Keep only what's needed to build: drop old designs and CAD-only files, move plate STLs to plate-source/
    [Controller.stl, Controller_9.200x6.100.stl]
2026-11-06 Sign radio messages so a fake or replayed packet can't arm or fire the field box
2026-11-06 Tidy wording in the wiring sheets and disclaimer
2026-11-07 Wiring sheet: LCD messages match the v3 firmware
2026-11-07 Document the optional 120 V wall-power channel
    README: the two ways to use a channel (12 V pyro, 120 V wall power), a parts
    table for the wall channel, wiring with a must-do safety checklist, wire-size
    note for the relay terminals, and extra before-every-use checks. Same section
    added to the field wiring guide, and a mains-voltage section in the disclaimer.
    No firmware change: ON/OFF and HOLD channel types already cover it.
2026-11-07 README: link to the 120 V wall-power channel from the intro
